edit-bautista/imu-leveling-platform/docs/wiring.jpg

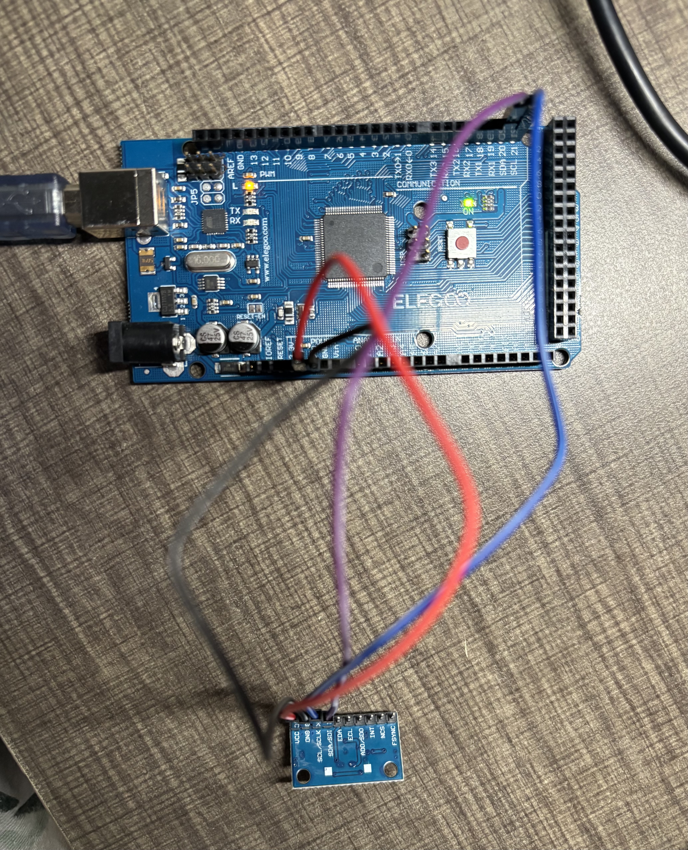
docs/wiring.jpg
