edit-bautista/imu-leveling-platform/(commit log)

2026-10-10 Add spec, wiring photo, WHO_AM_I sketch (MPU-6500 returns 0x70)
2026-10-11 Burst-read 14 bytes from 0x3B, print scaled 6-axis CSV
2026-10-14 Live plot and CSV logger for IMU serial stream
2026-10-14 Gyro bias calibration, complementary filter, 60-s drift measurement
    [log_20261013_202504.csv]
2026-10-14 Servo command test on pin 9, no brownout
    [servo_test.ino]
2026-10-15 Open-loop sweep: gain 0.88, level at servo cmd ~87, ~3 deg backlash
    [sweep_log.csv]
2026-10-23 Closed loop leveling: complementary filter + integral servo control at 200 Hz
2026-10-23 Closed-loop leveling at 200Hz + measurement logger
2026-10-23 Closed loop measured: worst ±2.6° up to 30° tilt, 200Hz; fix calibratino during servo move
    [level_tilt0.csv, level_tilt10.csv, level_tilt20.csv, level_tilt30.csv]
2026-10-23 Closed loop measured: worst ±2.6° up to 30° tilt, 200Hz; fix calibration during servo move
